RedTeamSkier/Optical-Data-Transmitter/transmitter/Optical_Tx.html

# Optical transmitter — screen patch

Start the decoder first. Max brightness, auto-brightness and night-light features off, on AC power. Keep the tab fullscreen & focused (animation throttles otherwise).

Message (text mode) HELLO OPTICAL WORLD …or send a file (file mode)

Clear file No file selected — sending text.

Frames / symbol

Inter-frame gap (black frames, rounded up to whole bits)

Loop continuously

Estimated transmit time

—

Go fullscreen & transmit

Space start / stop · F fullscreen · Esc stop & exit
